Killkase42/Microcontroller-Smartwatch/Images/gnd and vcc planes.jpg

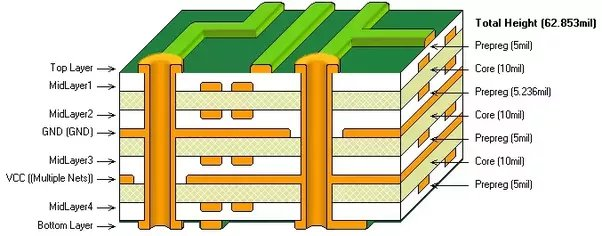
Images/gnd and vcc planes.jpg
