Killkase42/Microcontroller-Smartwatch/(commit log)

2022-09-25 Basic functionality without sensors
2023-06-11 second prototype, second iteration
2023-06-24 schematic iib
2024-04-28 Prototype 3 and final files
